telec16/bat-packed/battery_management.md

# Documentation

https://www.ti.com/tool/BQSTUDIO#downloads

# Protection/Monitoring/Control

- BQ76942 - $1.8 - TQFP-48 -  3-10 cells, Autonomous, internal ADC&Coulomb counter
- BQ76952 - $2.0 - TQFP-48 - 3-16 cells, Autonomous, internal ADC&Coulomb counter
- BQ77PL900 - $2.6 - SSOP-48 - 5-10 cells, Autonomous, no ADC
- HY2213 - $ - SOT-23-5 - Single cell balancing (stackable)
- FS312F-G - $ - SOIC-8 - Single cell protector (stackable)

# Charger

## Buck

- bq24630 - $1.76 - VQFN-24 - 1-7 cells (28V), Buck (need external boost), no communication (only enable pin)
- LTC4162-L - $3 - QFN-28 - 1-8 cells (35V), Buck (need external boost), internal ADC (collision with the monitor)

## Boost

- MC33063 - $0.2 - SOIC-8 - 3-40V, 1.5A, internal switch ?
- TL5001 - $0.37 - DIP-8 - 3.6-40V, external switch

## BuBo

- LT1618 - $1.86 - DFN-10/MSOP-10 - CC/CV 1.6V/18V to 35V BuBo 500mA
