telec16/bat-packed/kicad/end_pack/end_pack.stl

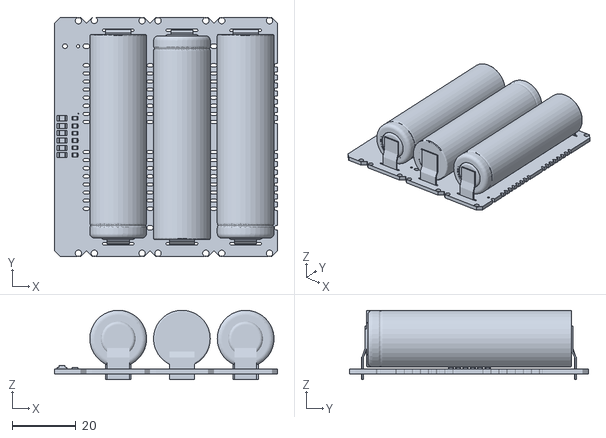
[picture p1: CAD file, 2021-04-30]
kicad/end_pack/end_pack.stl
70.0 x 75.0 x 21.8
