telec16/bat-packed/kicad/four_pack/four_cells.stl

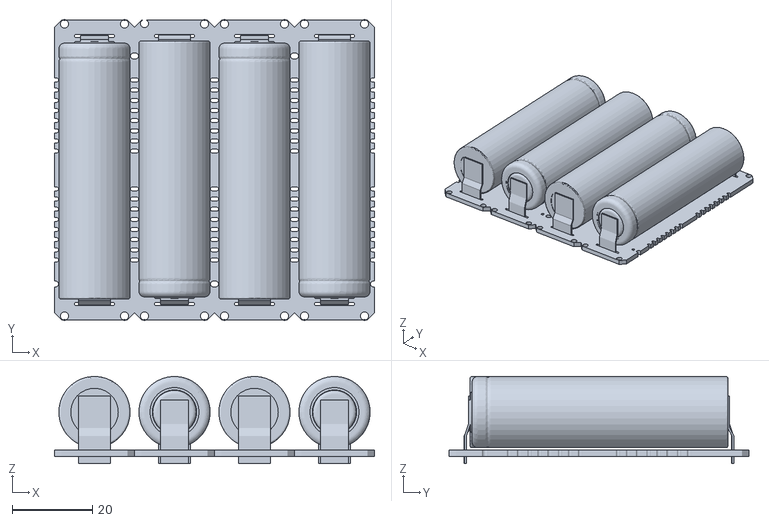
[picture p2: CAD file, 2021-04-30]
kicad/four_pack/four_cells.stl
80.0 x 75.0 x 21.8
