telec16/bat-packed/ltspice/CC-CV.asc

C1: cap; 100n
C2: cap; 1µ
Capacity: res; {load}
D1: schottky; MBR0520L
Ebatt: voltage; {2.8*7}
L1: ind; 10µ
L2: ind; 1µ
R1: res; 2Meg
R2: res; 100k
R3: res; 2.2Meg
R4: res; 200m
U1: LT1618
V1: voltage; 5
Named nets: 0, 5V, Vbatt
.tran 6m
.step dec param load 1 500 3
