telec16/bat-packed/kicad/end_pack/end_pack.kicad_pcb

## KiCad design kicad/end_pack/end_pack.kicad_pcb (2023-06-22)

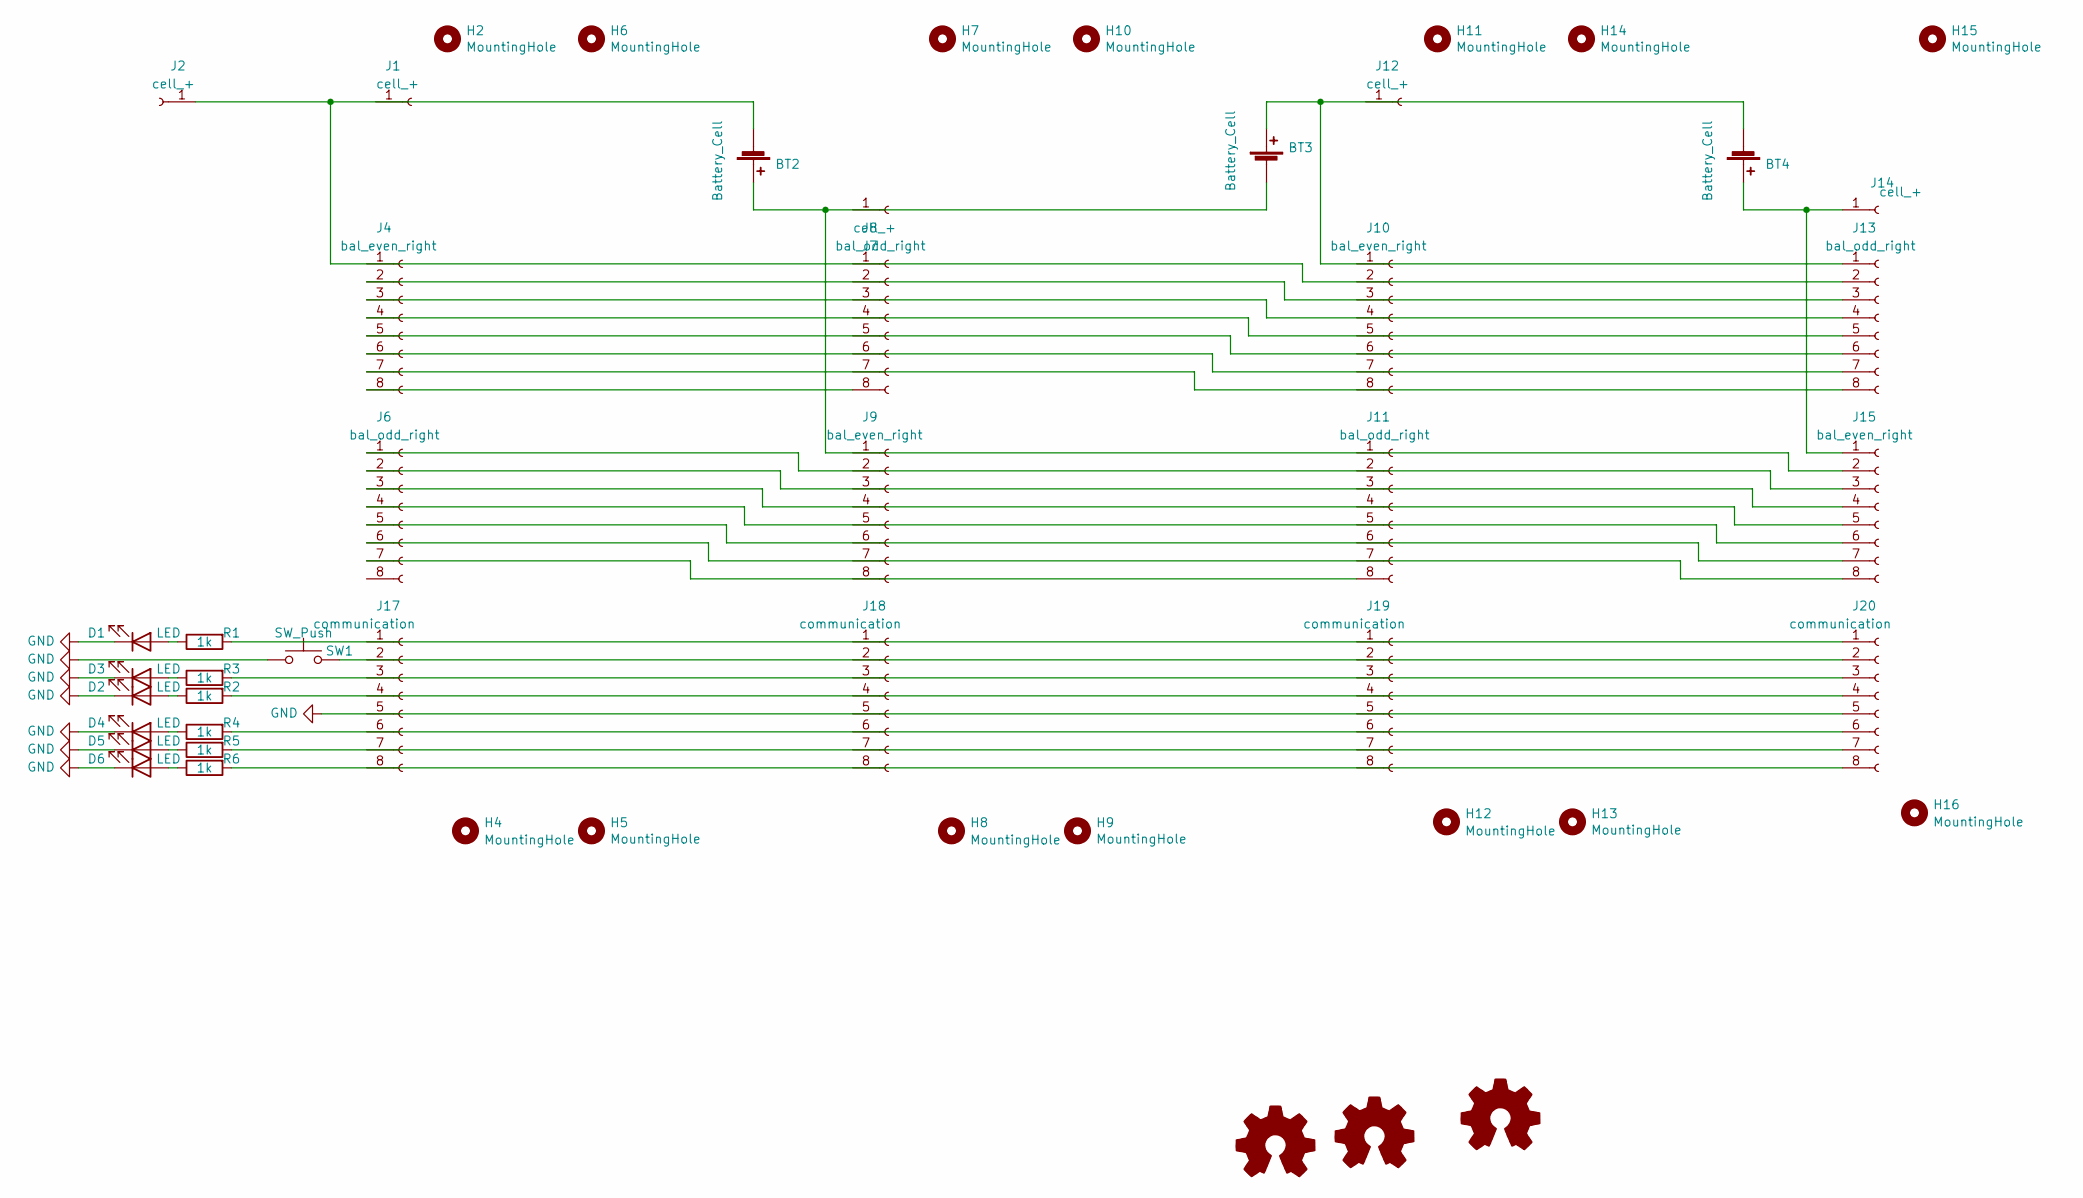
[picture p3: schematic end_pack.kicad_sch]

Parts:
BT2, BT3, BT4: Battery_Cell; Cell_18650
D1, D2, D3, D4, D5, D6: LED; LED_1206_3216Metric
H2, H4, H5, H6, H7, H8, H9, H10, H11, H12, H13, H14, H15, H16: MountingHole; MountingHole_2mm
J1, J7, J12: cell_+; Castellated_1x01_P5.08mm_Triple
J2: cell_+; Pin_D1.3mm_L11.0mm_LooseFit
J4, J9, J10, J15: bal_even_right; Castellated_1x08_P2.54mm
J6, J8, J11, J14: bal_odd_right; Castellated_1x08_P2.54mm
J13: cell_+; Castellated_1x01_P5.08mm_Double
J17, J18, J19, J20: communication; DualSide_2x05_P1.27mm_Vertical_SMD
LOGO1, LOGO2, LOGO3: Logo_Open_Hardware_Small; batpacked-24
R1, R2, R3, R4, R5, R6: 1k; R_0805_2012Metric
SW1: SW_Push; SW_Push_SPST_NO_Alps_SKRK

Connections:
GND: D1.1 (K), D2.1 (K), D3.1 (K), D4.1 (K), D5.1 (K), D6.1 (K), J20.5, SW1.2
unnamed: BT2.1 (+), BT3.2 (-), J15.2
unnamed: BT2.2 (-), J2.1, J14.2
unnamed: BT3.1 (+), BT4.2 (-), J14.1
unnamed: BT4.1 (+), J13.1, J15.1
unnamed: D1.2 (A), R1.1
unnamed: D2.2 (A), R2.1
unnamed: D3.2 (A), R3.1
unnamed: D4.2 (A), R4.1
unnamed: D5.2 (A), R5.1
unnamed: D6.2 (A), R6.1
unnamed: J4.8, J8.8
unnamed: J6.7, J11.8
unnamed: J4.2, J14.3
unnamed: J4.3, J14.4
unnamed: J4.4, J14.5
unnamed: J4.5, J14.6
unnamed: J4.6, J14.7
unnamed: J4.7, J14.8
unnamed: J6.1, J15.3
unnamed: J6.2, J15.4
unnamed: J6.3, J15.5
unnamed: J6.4, J15.6
unnamed: J6.5, J15.7
unnamed: J6.6, J15.8
unnamed: J20.1, R1.2
unnamed: J20.2, SW1.1
unnamed: J20.3, R3.2
unnamed: J20.4, R2.2
unnamed: J20.6, R4.2
unnamed: J20.7, R5.2
unnamed: J20.8, R6.2

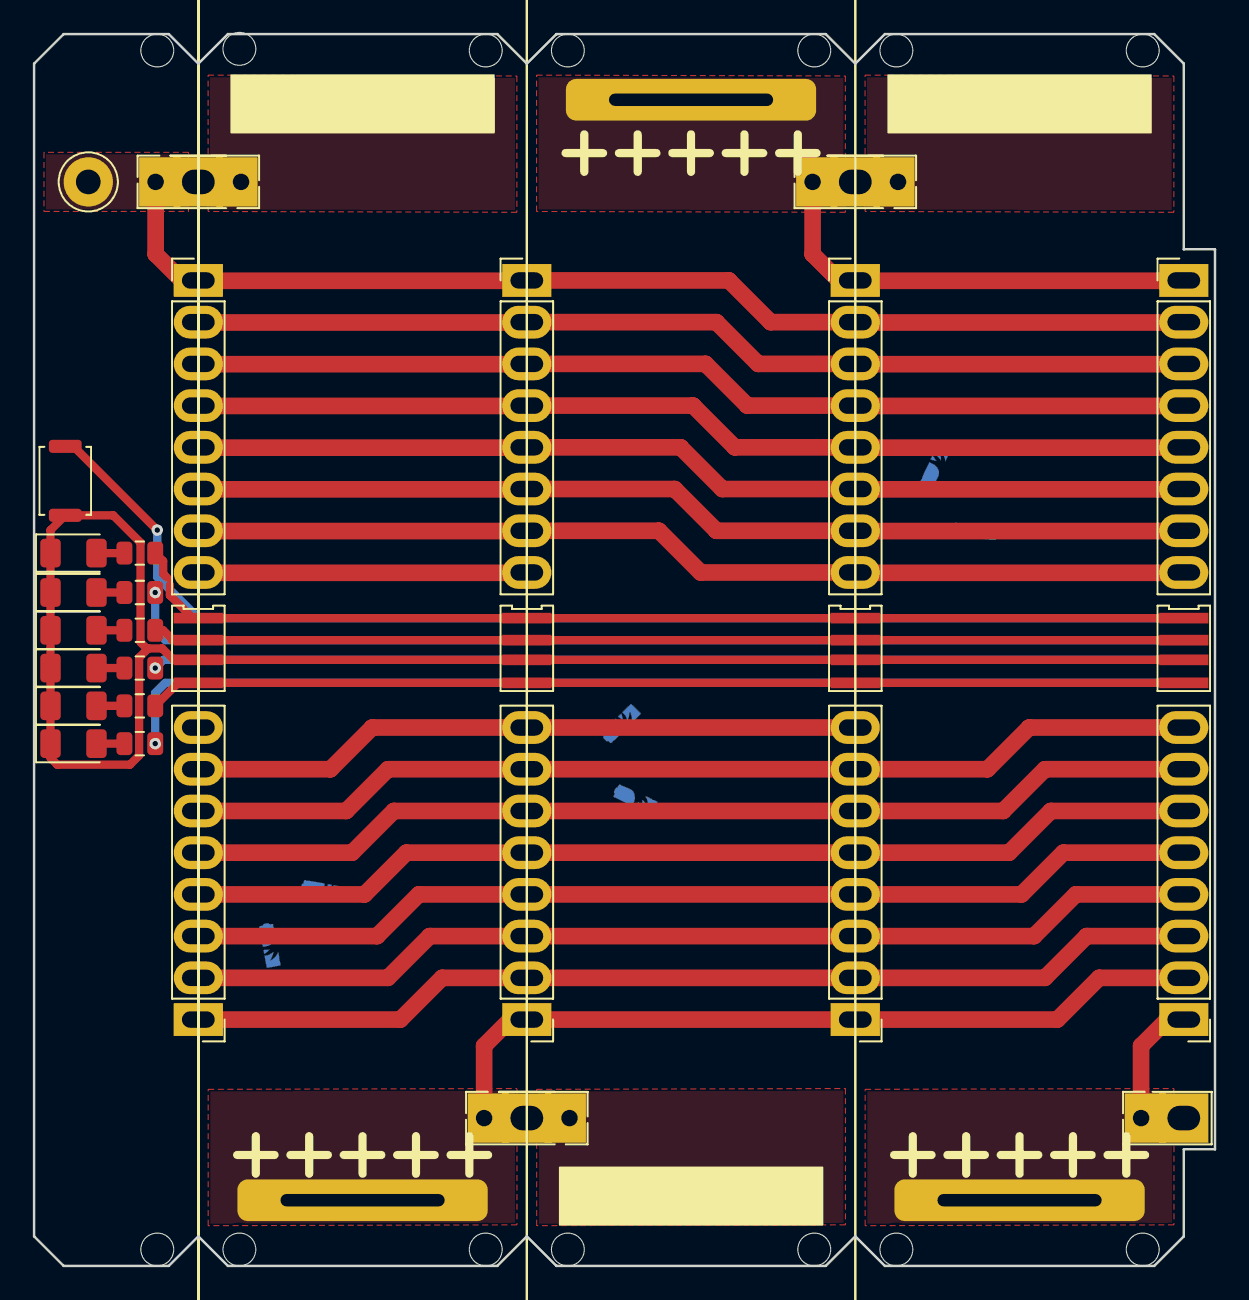
[picture p4: board end_pack.kicad_pcb from above]

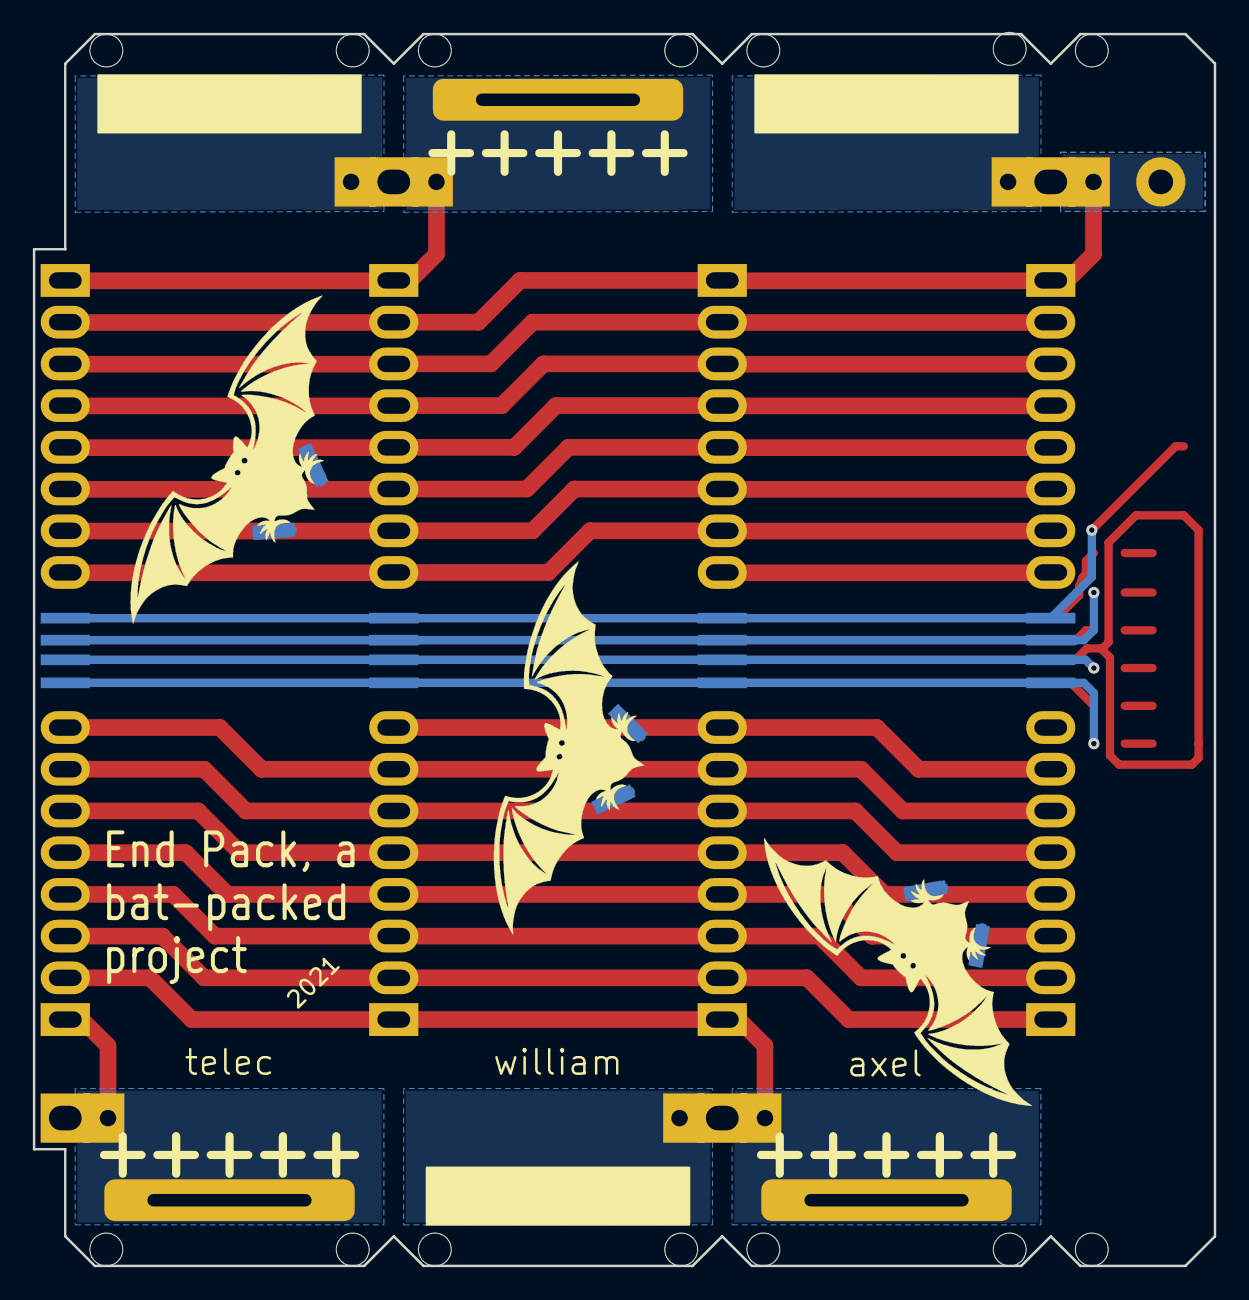
[picture p5: board end_pack.kicad_pcb from below]

Board: 2 copper layers, 71.9 x 75.0 mm, 50 parts (3 on the bottom side), 32 nets.
