telec16/bat-packed/kicad/single_cell/stackable_cells_self_contained.kicad_pcb

## KiCad design kicad/single_cell/stackable_cells_self_contained.kicad_pcb (2023-06-22)

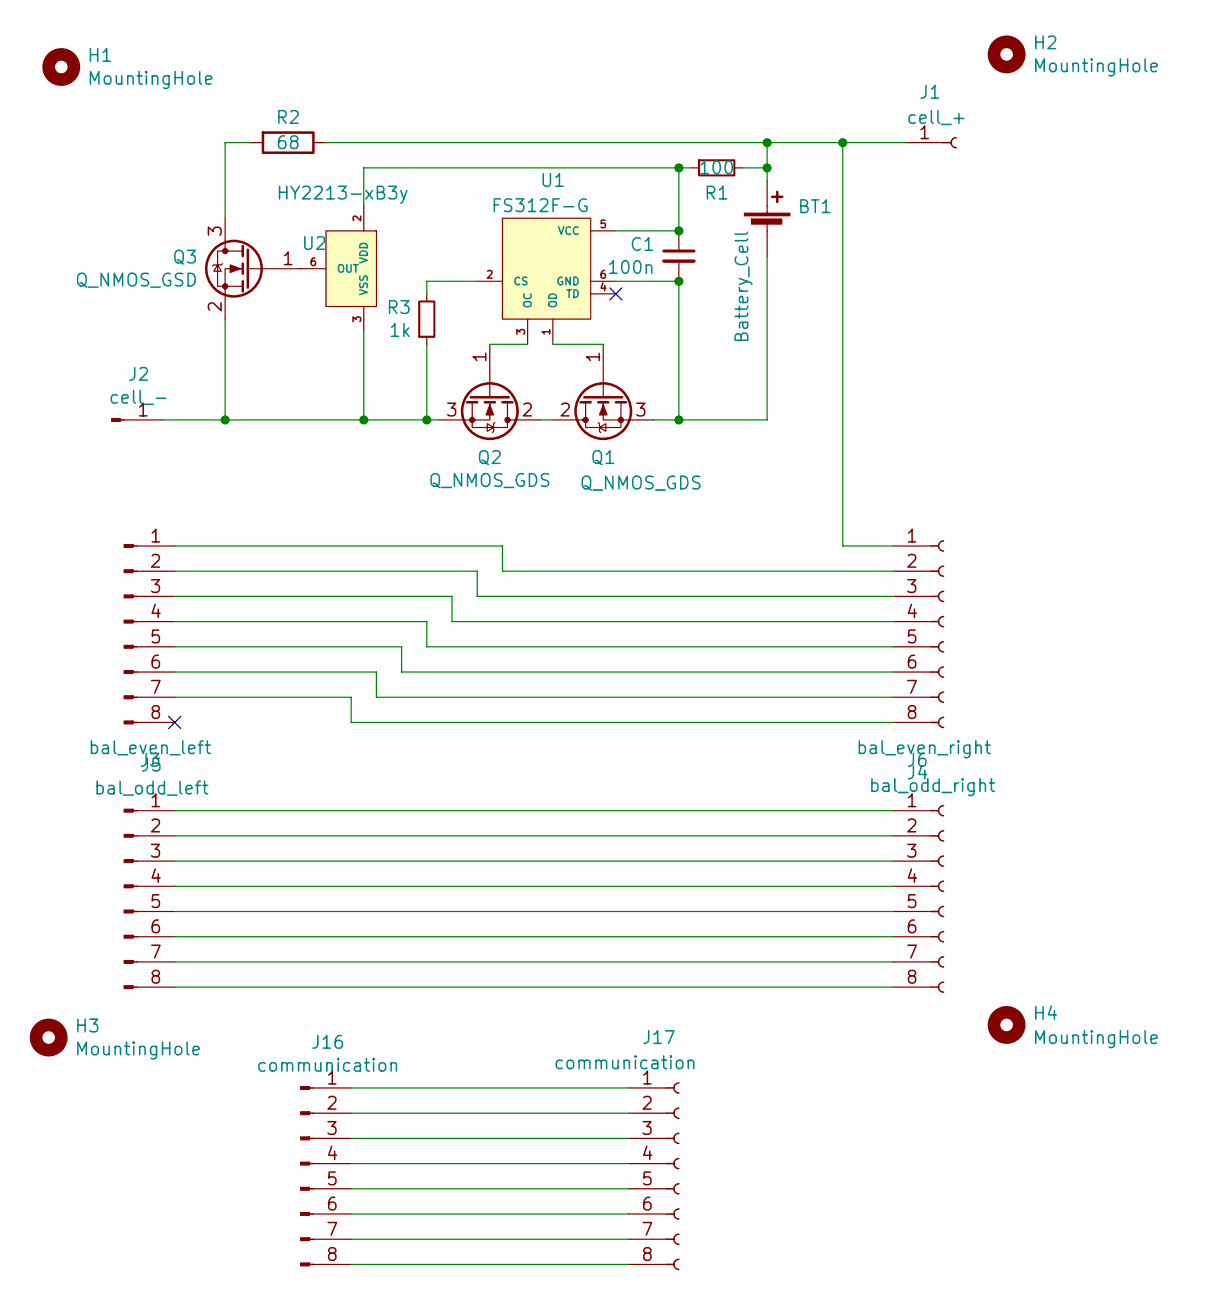
[picture p6: schematic stackable_cells_self_contained.kicad_sch]

Parts:
BT1: Battery_Cell; Cell_18650
C1: 100n; C_0603_1608Metric
H1, H2, H3, H4: MountingHole; MountingHole_2mm
J1: cell_+; Castellated_1x01_P5.08mm_Double
J2: cell_-; Castellated_1x01_P5.08mm_Double
J3: bal_even_left; Castellated_1x08_P2.54mm
J4: bal_even_right; Castellated_1x08_P2.54mm
J5: bal_odd_left; Castellated_1x08_P2.54mm
J6: bal_odd_right; Castellated_1x08_P2.54mm
J16, J17: communication; DualSide_2x05_P1.27mm_Vertical_SMD
Q1, Q2: Q_NMOS_GDS; TO-252-2
Q3: Q_NMOS_GSD; SOT-23
R1: 100; R_0603_1608Metric
R2: 68; R_1206_3216Metric
R3: 1k; R_0603_1608Metric
U1: FS312F-G; SOT-23-6
U2: HY2213-xB3y; SOT-23-6

Connections:
unnamed: BT1.1 (+), J1.1, J4.1, R1.2, R2.1
unnamed: BT1.2 (-), C1.2, Q1.3 (S), U1.6 (GND)
unnamed: J2.1, Q2.3 (S), Q3.2 (S), R3.1, U2.3 (VSS)
unnamed: J3.1, J4.2
unnamed: J3.2, J4.3
unnamed: J3.3, J4.4
unnamed: J3.4, J4.5
unnamed: J3.5, J4.6
unnamed: J3.6, J4.7
unnamed: J3.7, J4.8
unnamed: J5.1, J6.1
unnamed: J5.2, J6.2
unnamed: J5.3, J6.3
unnamed: J5.4, J6.4
unnamed: J5.5, J6.5
unnamed: J5.6, J6.6
unnamed: J5.7, J6.7
unnamed: J5.8, J6.8
unnamed: J16.1, J17.1
unnamed: J16.2, J17.2
unnamed: J16.3, J17.3
unnamed: J16.4, J17.4
unnamed: J16.5, J17.5
unnamed: J16.6, J17.6
unnamed: J16.7, J17.7
unnamed: J16.8, J17.8
unnamed: Q1.2 (D), Q2.2 (D)
unnamed: Q1.1 (G), U1.1 (OD)
unnamed: Q2.1 (G), U1.3 (OC)
unnamed: Q3.3 (D), R2.2
unnamed: Q3.1 (G), U2.6 (OUT)
unnamed: R3.2, U1.2 (CS)
unnamed: C1.1, R1.1, U1.5 (VCC), U2.2 (VDD)

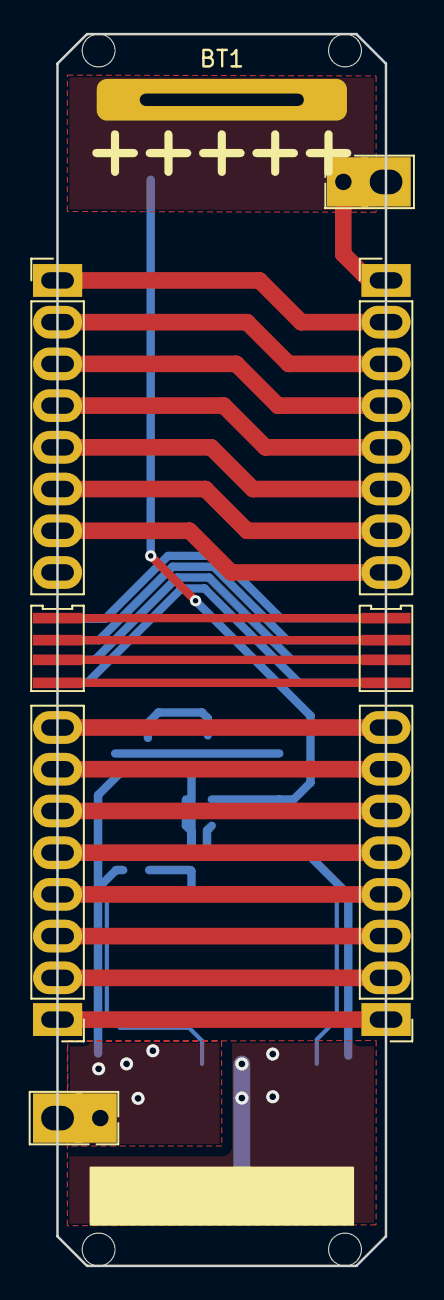
[picture p7: board stackable_cells_self_contained.kicad_pcb from above]

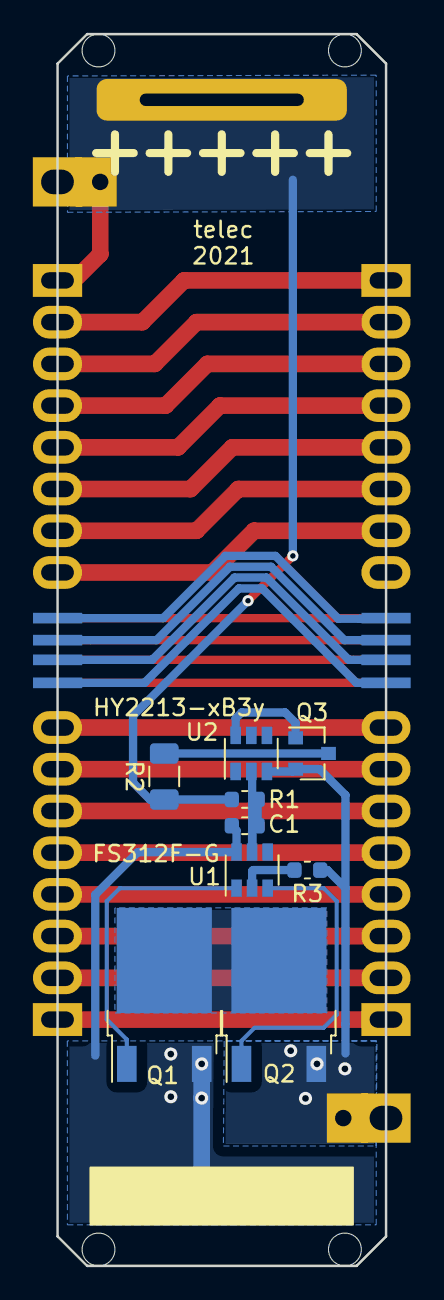
[picture p8: board stackable_cells_self_contained.kicad_pcb from below]

Board: 2 copper layers, 20.0 x 75.0 mm, 22 parts (9 on the bottom side), 33 nets.
