telec16/bat-packed/kicad/four_pack/four_cells.kicad_pcb

## KiCad design kicad/four_pack/four_cells.kicad_pcb (2023-06-22)

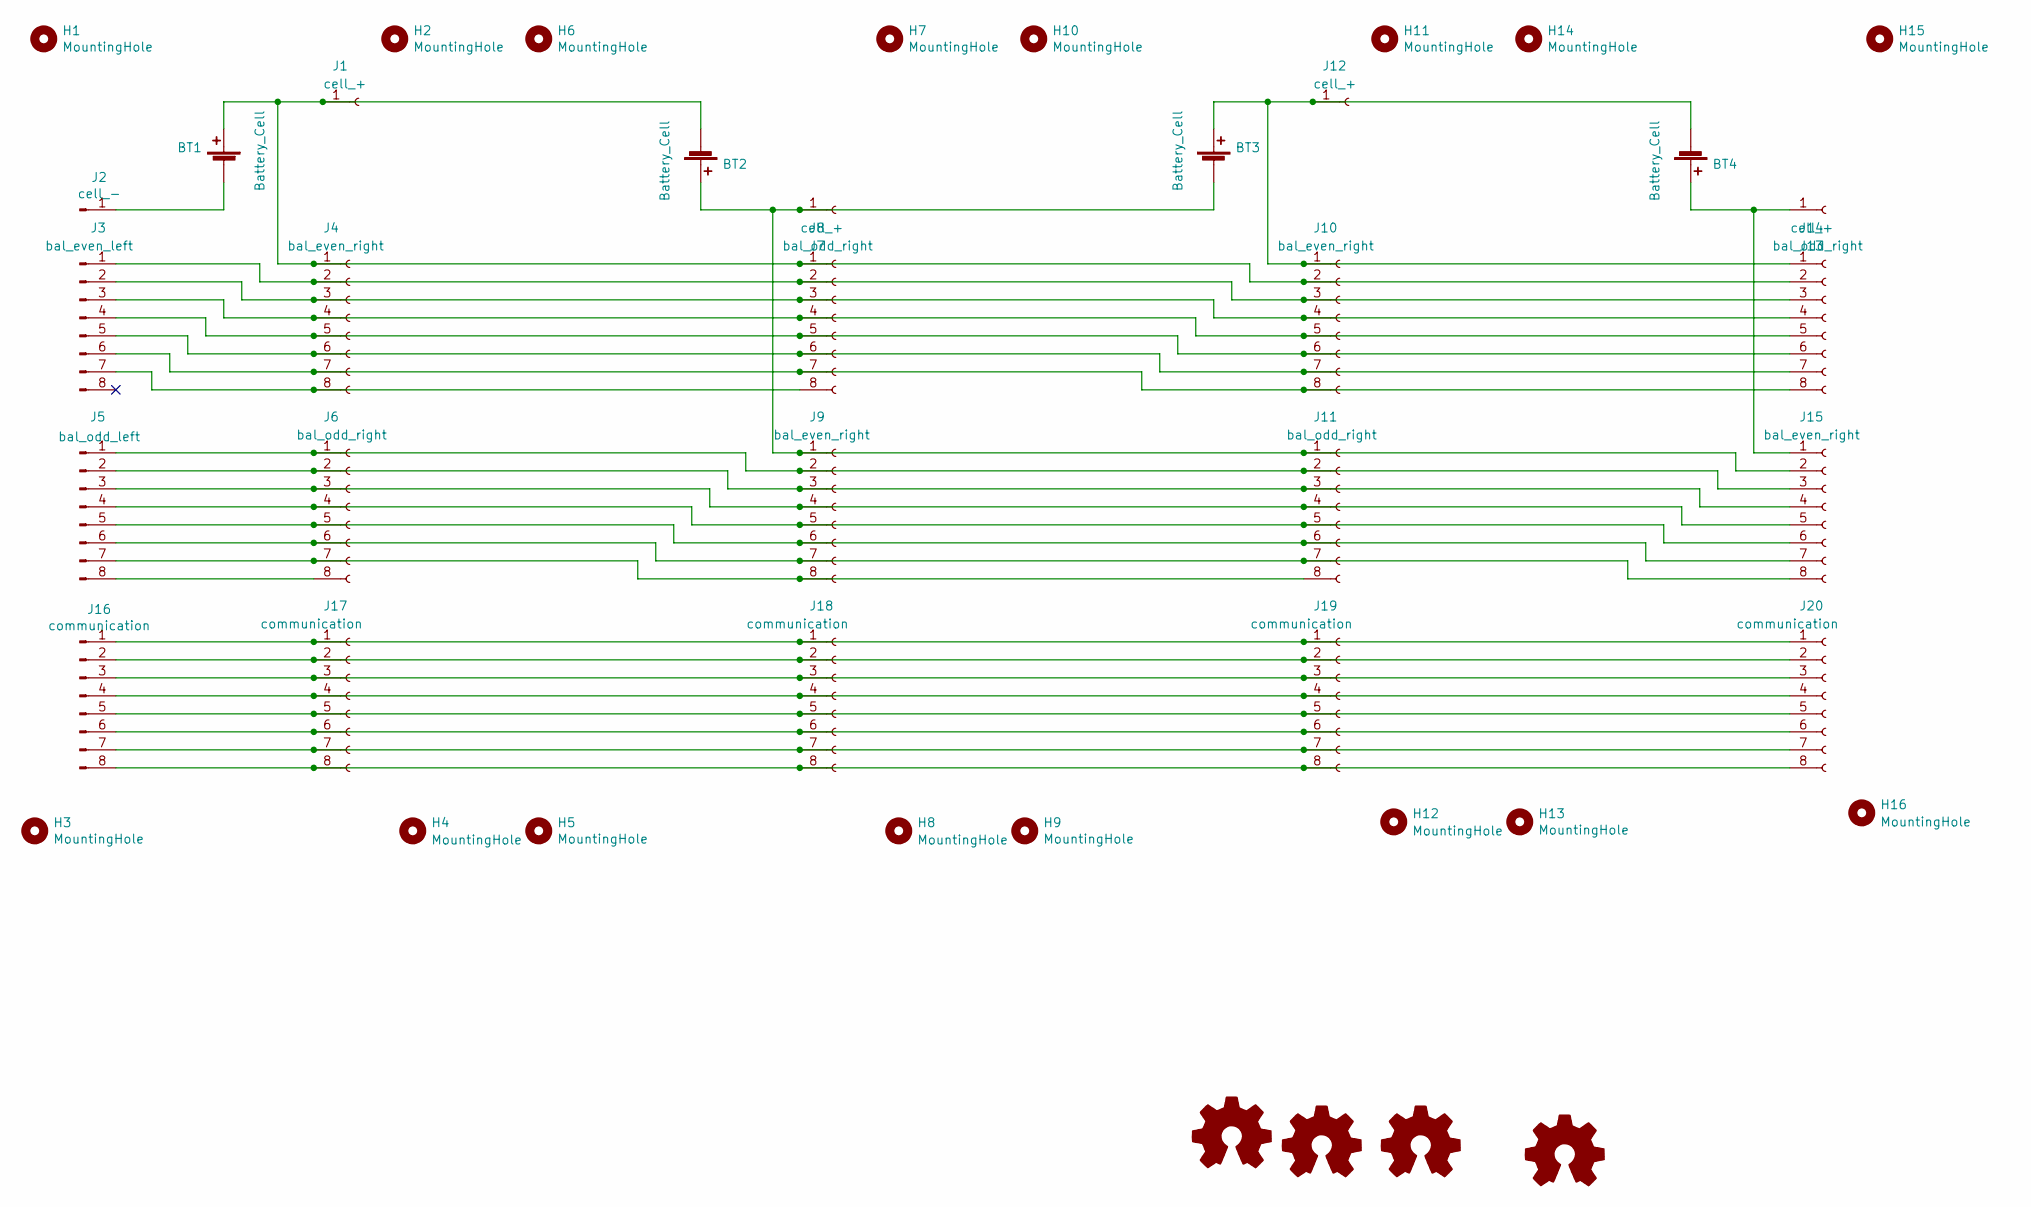
[picture p9: schematic four_cells.kicad_sch]

Parts:
BT1, BT2, BT3, BT4: Battery_Cell; Cell_18650
H1, H2, H3, H4, H5, H6, H7, H8, H9, H10, H11, H12, H13, H14, H15, H16: MountingHole; MountingHole_2mm
J1, J7, J12: cell_+; Castellated_1x01_P5.08mm_Triple
J2: cell_-; Castellated_1x01_P5.08mm_Double
J3: bal_even_left; Castellated_1x08_P2.54mm
J4, J9, J10, J15: bal_even_right; Castellated_1x08_P2.54mm
J5: bal_odd_left; Castellated_1x08_P2.54mm
J6, J8, J11, J14: bal_odd_right; Castellated_1x08_P2.54mm
J13: cell_+; Castellated_1x01_P5.08mm_Double
J16, J17, J18, J19, J20: communication; DualSide_2x05_P1.27mm_Vertical_SMD
LOGO1, LOGO2, LOGO3, LOGO4: Logo_Open_Hardware_Small; batpacked-24

Connections:
unnamed: BT1.1 (+), BT2.2 (-), J1.1, J4.1, J8.1, J10.2, J14.2
unnamed: BT1.2 (-), J2.1
unnamed: BT2.1 (+), BT3.2 (-), J7.1, J9.1, J11.1, J15.2
unnamed: BT3.1 (+), BT4.2 (-), J10.1, J12.1, J14.1
unnamed: BT4.1 (+), J13.1, J15.1
unnamed: J3.7, J4.8, J8.8
unnamed: J5.8, J6.8
unnamed: J3.1, J4.2, J8.2, J10.3, J14.3
unnamed: J3.2, J4.3, J8.3, J10.4, J14.4
unnamed: J3.3, J4.4, J8.4, J10.5, J14.5
unnamed: J3.4, J4.5, J8.5, J10.6, J14.6
unnamed: J3.5, J4.6, J8.6, J10.7, J14.7
unnamed: J3.6, J4.7, J8.7, J10.8, J14.8
unnamed: J5.1, J6.1, J9.2, J11.2, J15.3
unnamed: J5.2, J6.2, J9.3, J11.3, J15.4
unnamed: J5.3, J6.3, J9.4, J11.4, J15.5
unnamed: J5.4, J6.4, J9.5, J11.5, J15.6
unnamed: J5.5, J6.5, J9.6, J11.6, J15.7
unnamed: J5.6, J6.6, J9.7, J11.7, J15.8
unnamed: J5.7, J6.7, J9.8, J11.8
unnamed: J16.1, J17.1, J18.1, J19.1, J20.1
unnamed: J16.2, J17.2, J18.2, J19.2, J20.2
unnamed: J16.3, J17.3, J18.3, J19.3, J20.3
unnamed: J16.4, J17.4, J18.4, J19.4, J20.4
unnamed: J16.5, J17.5, J18.5, J19.5, J20.5
unnamed: J16.6, J17.6, J18.6, J19.6, J20.6
unnamed: J16.7, J17.7, J18.7, J19.7, J20.7
unnamed: J16.8, J17.8, J18.8, J19.8, J20.8

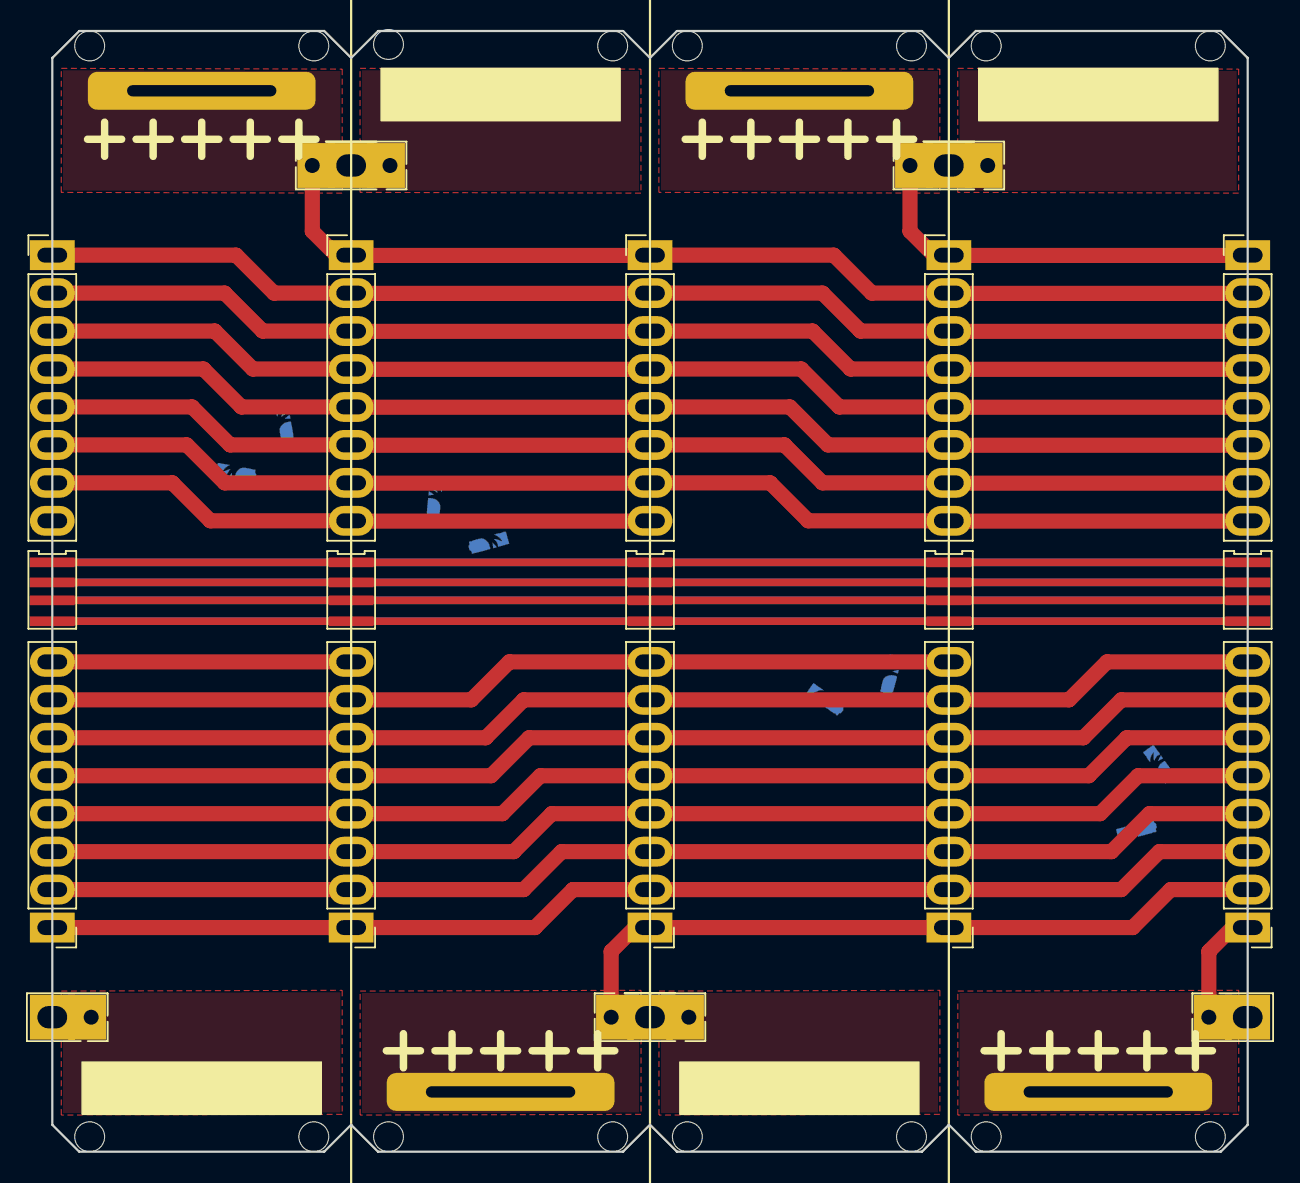
[picture p10: board four_cells.kicad_pcb from above]

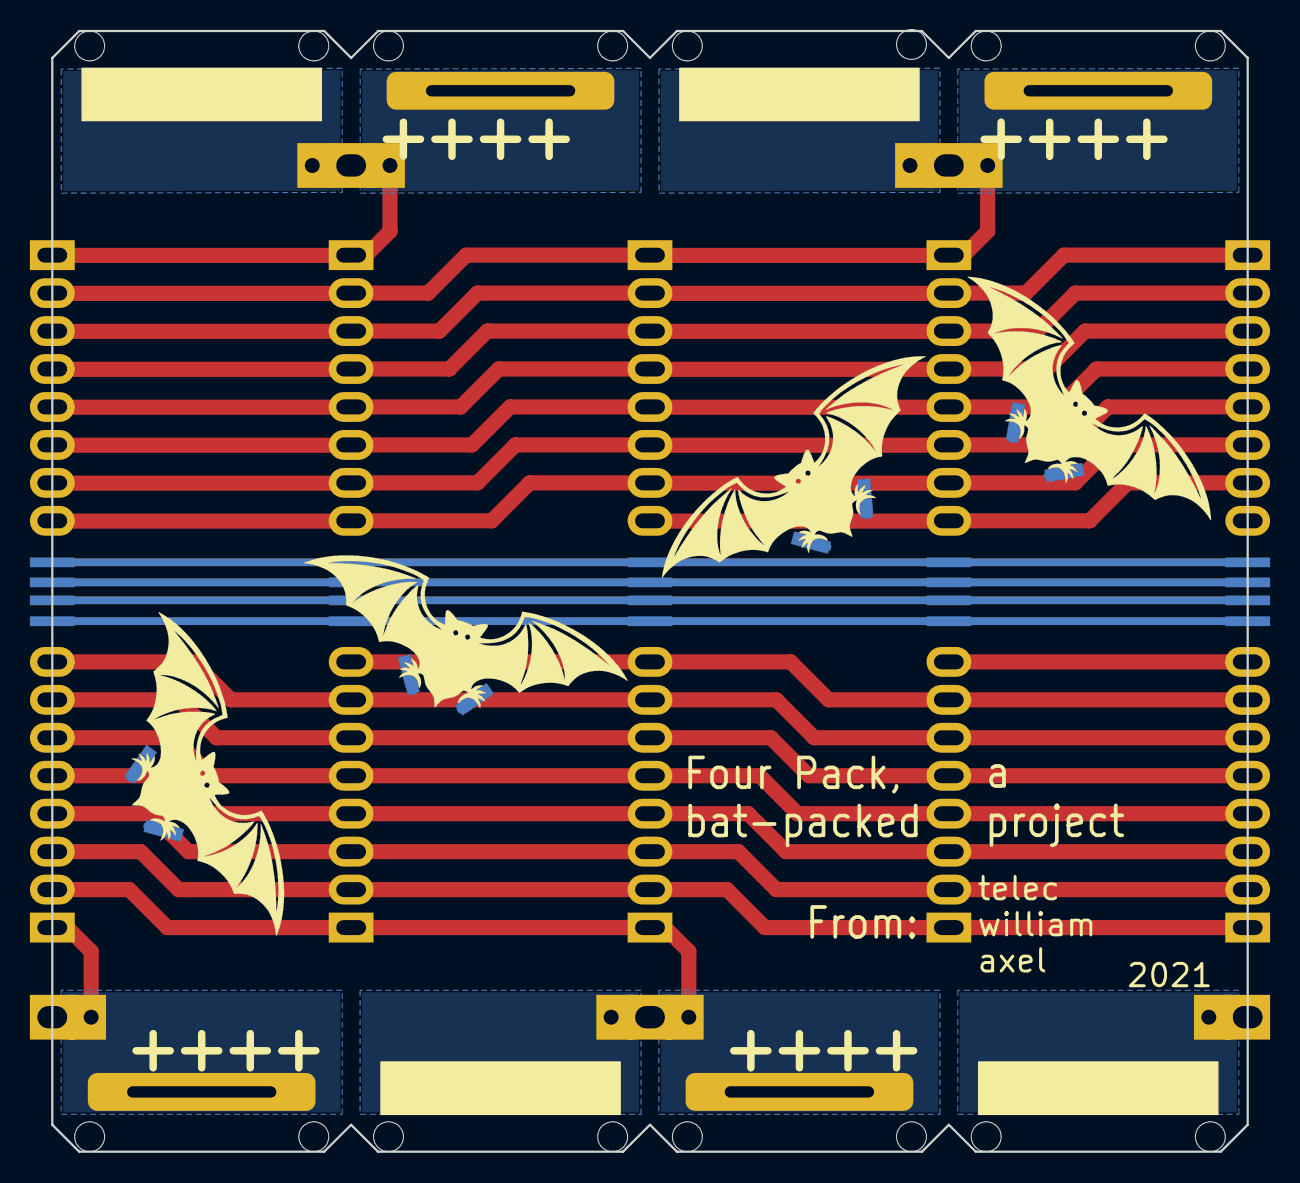
[picture p11: board four_cells.kicad_pcb from below]

Board: 2 copper layers, 80.0 x 75.0 mm, 44 parts (4 on the bottom side), 28 nets.
