telec16/bat-packed/(commit log)

2021-04-27 stackable cell PCB
    [stackable_cells.kicad_pcb, stackable_cells.sch]
2021-04-27 self contained cell pcb
    [stackable_cells_self_contained.kicad_pcb, stackable_cells_self_contained.sch]
2021-04-28 Some assumptions on CAN
    [Recording1.csv, Recording2.csv]
2021-04-29 battery management draft
2021-04-29 Finished four cells PCB
    [four_cells.kicad_pcb, four_cells.sch, stackable_cells.kicad_pcb, stackable_cells.sch, stackable_cells_self_contained.kicad_pcb, stackable_cells_self_contained.sch]
2021-04-30 Openscad model
    [original_pack.scad]
2021-04-30 Pack model nearly done
    [original_pack.scad]
2021-04-30 Pack model finished
    [custom_modules.scad, one_layer_pack.scad, original_pack.scad, pack_modules.scad]
2021-04-30 Small change
    [four_cells.kicad_pcb]
2021-04-30 added PCB model
    [custom_modules.scad, one_layer_pack.scad]
2021-04-30 PCB 3D model
    [four_cells.stl]
2021-04-30 Now with colors!
    [one_layer_pack.scad]
2021-04-30 Ending PCB finished
    [end_pack.kicad_pcb, end_pack.sch, four_cells.kicad_pcb]
2021-04-30 Added end PCB
    [custom_modules.scad, one_layer_pack.scad]
2021-04-30 added cell model
    [end_pack.kicad_pcb, end_pack.stl, four_cells.kicad_pcb, four_cells.stl]
2021-05-09 Starting BMS PCB
    [BMS.kicad_pcb, BMS.sch]
2021-05-10 More on the charger
    [BMS.sch]
2021-07-26 gerber + logo
    [four_cells.kicad_pcb, four_cells.sch]
2021-07-26 finished stackable design
    [stackable_cells_self_contained.kicad_pcb, stackable_cells_self_contained.sch]
2021-07-27 silkscreen correction
    [end_pack.kicad_pcb]
2021-07-28 fix silkscreen + hole location
    [end_pack.kicad_pcb, four_cells.kicad_pcb]
2023-06-22 Updated to kicad 7.x
    [BMS.kicad_sch, end_pack.kicad_pcb, end_pack.kicad_sch, four_cells.kicad_pcb, four_cells.kicad_sch, stackable_cells.kicad_pcb, stackable_cells.kicad_sch, stackable_cells_self_contained.kicad_pcb]
